SuperHouse/PWC/Hardware/PWC.brd

## EAGLE design Hardware/PWC.brd (2021-07-06)

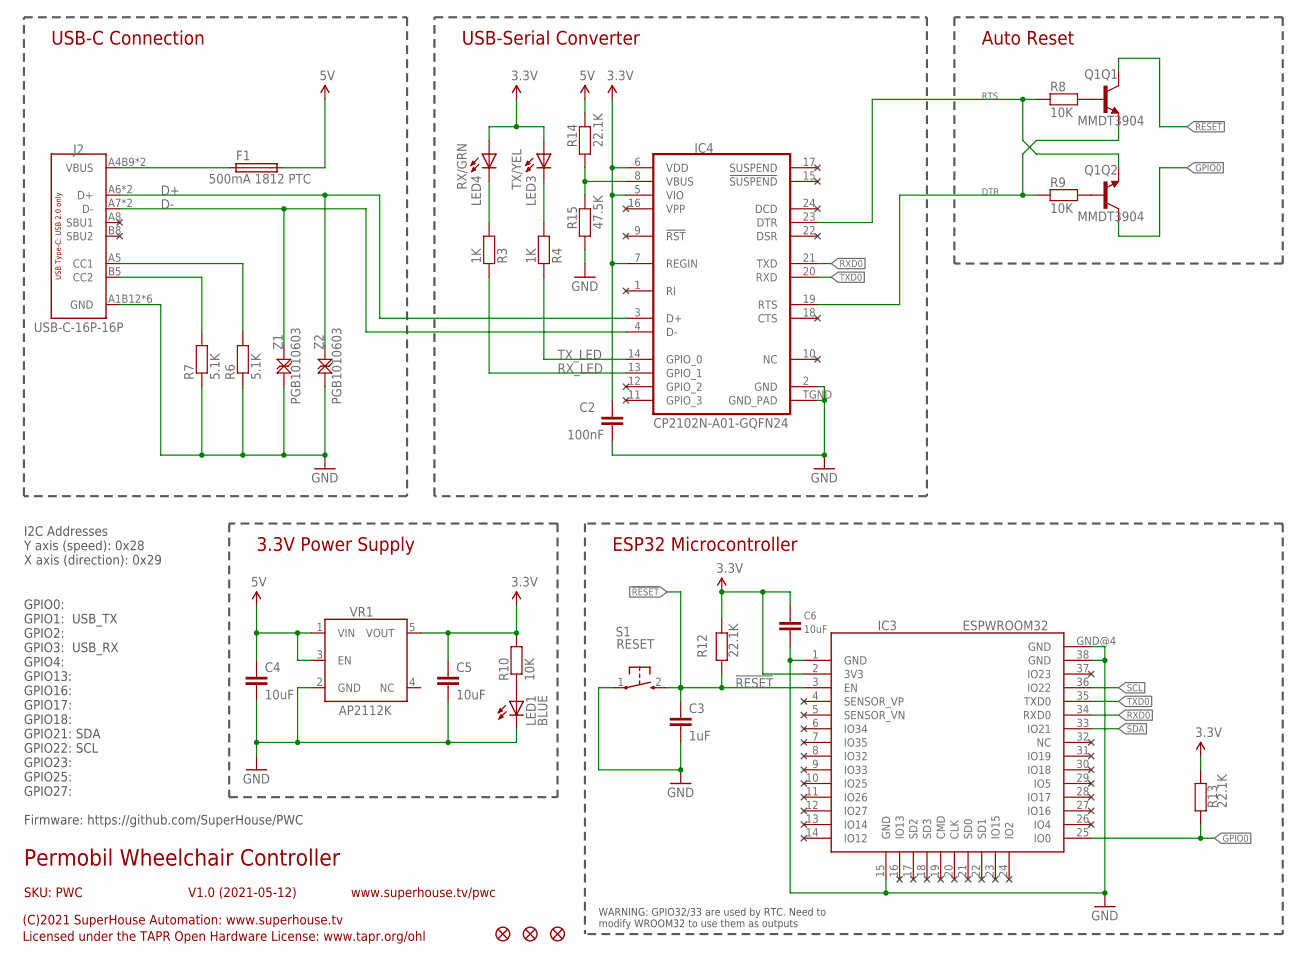
[picture p2: schematic PWC.sch, sheet 1]

Parts:
C2: 100nF; C0603
C3: 1uF; C0603
C4, C5, C6: 10uF; C0805
F1: 500mA 1812 PTC; 1812
IC3: ESPWROOM32
IC4: CP2102N-A01-GQFN24; QFN-24
J2: USB-C-16P-16P; USB-C-16P
LED1: BLUE; LED-0603
LED3: TX/YEL; LED-0603
LED4: RX/GRN; LED-0603
Q1: MMDT3904; SOT-363
R3, R4: 1K; R0603
R6, R7: 5.1K; R0603
R8, R9, R10: 10K; R0603
R12, R13, R14: 22.1K; R0603
R15: 47.5K; R0603
S1: RESET; TACTILE_SMT_3X4X2
U$35, U$36, U$37: FIDUCIAL1X2; FIDUCIAL-1X2
VR1: AP2112KSOT25; SOT23-5
Z1, Z2: PGB1010603; TVS0603

Connections:
3.3V: C2.1, C5.1, C6.1, IC3.2 (3V3), IC4.5 (VIO), IC4.6 (VDD), IC4.7 (REGIN), LED3.A, LED4.A, R10.2, R12.1, R13.1, VR1.5 (VOUT); also elsewhere on the board
5V: C4.1, F1.2, R14.2, VR1.1 (VIN), VR1.3 (EN)
!RESET: C3.1, IC3.3 (EN), Q1.3 (C), R12.2, S1.2 (S)
D+: IC4.3 (D+), J2.A6 (D+), J2.B6 (D+), Z2.2
D-: IC4.4 (D-), J2.A7 (D-), J2.B7 (D-), Z1.2
DTR: IC4.23 (DTR), Q1.1 (E), R8.1
GND: C2.2, C3.2, C4.2, C5.2, C6.2, IC3.1 (GND), IC3.15 (GND), IC3.38 (GND), IC3.GND@4 (GND), IC4.2 (GND), IC4.TGND (GND_PAD), J2.A1B12 (GND), J2.A12B1 (GND), J2.FIX1 (GND), J2.FIX2 (GND), J2.FIX3 (GND), J2.FIX4 (GND), LED1.C, R6.1, R7.1, R15.1, S1.1, VR1.2 (GND), Z1.1, Z2.1; also elsewhere on the board
GPIO0: IC3.25 (IO0), Q1.6 (C), R13.2
unnamed: LED1.A, R10.1
unnamed: Q1.5 (B), R8.2
unnamed: Q1.2 (B), R9.2
unnamed: LED4.C, R3.2
unnamed: J2.B5 (CC2), R7.2
unnamed: J2.A5 (CC1), R6.2
unnamed: LED3.C, R4.2
unnamed: IC4.8 (VBUS), R14.1, R15.2
RTS: IC4.19 (RTS), Q1.4 (E), R9.1
RXD0: IC3.34 (RXD0), IC4.21 (TXD)
RX_LED: IC4.13 (GPIO_1), R3.1
SCL: IC3.36 (IO22); also elsewhere on the board
SDA: IC3.33 (IO21); also elsewhere on the board
TXD0: IC3.35 (TXD0), IC4.20 (RXD)
TX_LED: IC4.14 (GPIO_0), R4.1
VIN: F1.1, J2.A4B9 (VBUS), J2.A9B4 (VBUS)

Notes on the sheet:
USB-C Connection
USB-Serial Converter
Auto Reset
3.3V Power Supply
ESP32 Microcontroller
WARNING: GPIO32/33 are used by RTC. Need to modify WROOM32 to use them as outputs
GPIO0: GPIO1: USB_TX GPIO2: GPIO3: USB_RX GPIO4: GPIO13: GPIO16: GPIO17: GPIO18: GPIO21: SDA GPIO22: SCL GPIO23: GPIO25: GPIO27: Firmware: https://github.com/SuperHouse/PWC
Permobil Wheelchair Controller
V1.0 (2021-05-12)
SKU: PWC
(C)2021 SuperHouse Automation: www.superhouse.tv
Licensed under the TAPR Open Hardware License: www.tapr.org/ohl
www.superhouse.tv/pwc
I2C Addresses Y axis (speed): 0x28 X axis (direction): 0x29

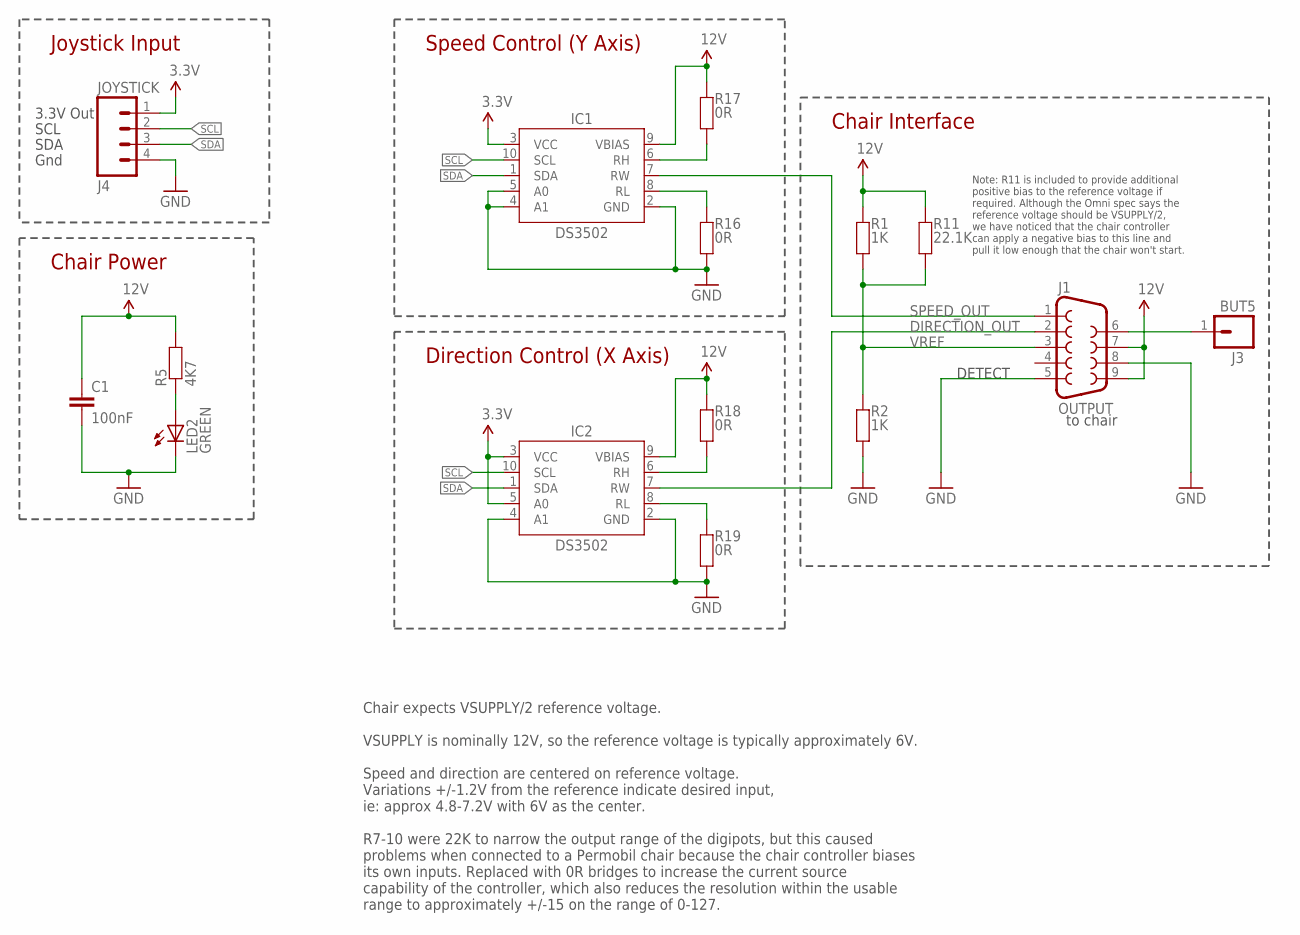
[picture p3: schematic PWC.sch, sheet 2]

Parts:
C1: 100nF; C0603
IC1, IC2: DS3502; MSOP10
J1: OUTPUT; DB9-PCB-SOCKET
J3: BUT5; 1X01
J4: JOYSTICK; 1X04
LED2: GREEN; LED-0603
R1, R2: 1K; R0603
R5: 4K7; R0603
R11: 22.1K; R0603
R16, R17, R18, R19: 0R; R0603

Connections:
3.3V: IC1.3 (VCC), IC2.3 (VCC), IC2.5 (A0), J4.1; also elsewhere on the board
12V: C1.1, IC1.9 (VBIAS), IC2.9 (VBIAS), J1.7, J1.9, R1.2, R5.2, R11.2, R17.2, R18.2
BUT5: J1.6, J3.1
DIRECTION_OUT: IC2.7 (RW), J1.2
GND: C1.2, IC1.2 (GND), IC1.4 (A1), IC1.5 (A0), IC2.2 (GND), IC2.4 (A1), J1.5, J1.8, J4.4, LED2.C, R2.1, R16.1, R19.1; also elsewhere on the board
unnamed: IC1.6 (RH), R17.1
unnamed: IC2.6 (RH), R18.1
unnamed: IC1.8 (RL), R16.2
unnamed: LED2.A, R5.1
unnamed: IC2.8 (RL), R19.2
SCL: IC1.10 (SCL), IC2.10 (SCL), J4.2; also elsewhere on the board
SDA: IC1.1 (SDA), IC2.1 (SDA), J4.3; also elsewhere on the board
SPEED_OUT: IC1.7 (RW), J1.1
VREF: J1.3, R1.1, R2.2, R11.1

Notes on the sheet:
to chair
Direction Control (X Axis)
Speed Control (Y Axis)
Chair Interface
Note: R11 is included to provide additional positive bias to the reference voltage if required. Although the Omni spec says the reference voltage should be VSUPPLY/2, we have noticed that the chair controller can apply a negative bias to this line and pull it low enough that the chair won't start.
DETECT
Chair Power
Chair expects VSUPPLY/2 reference voltage. VSUPPLY is nominally 12V, so the reference voltage is typically approximately 6V. Speed and direction are centered on reference voltage. Variations +/-1.2V from the reference indicate desired input, ie: approx 4.8-7.2V with 6V as the center. R7-10 were 22K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
Joystick Input
3.3V Out
SCL
SDA
Gnd

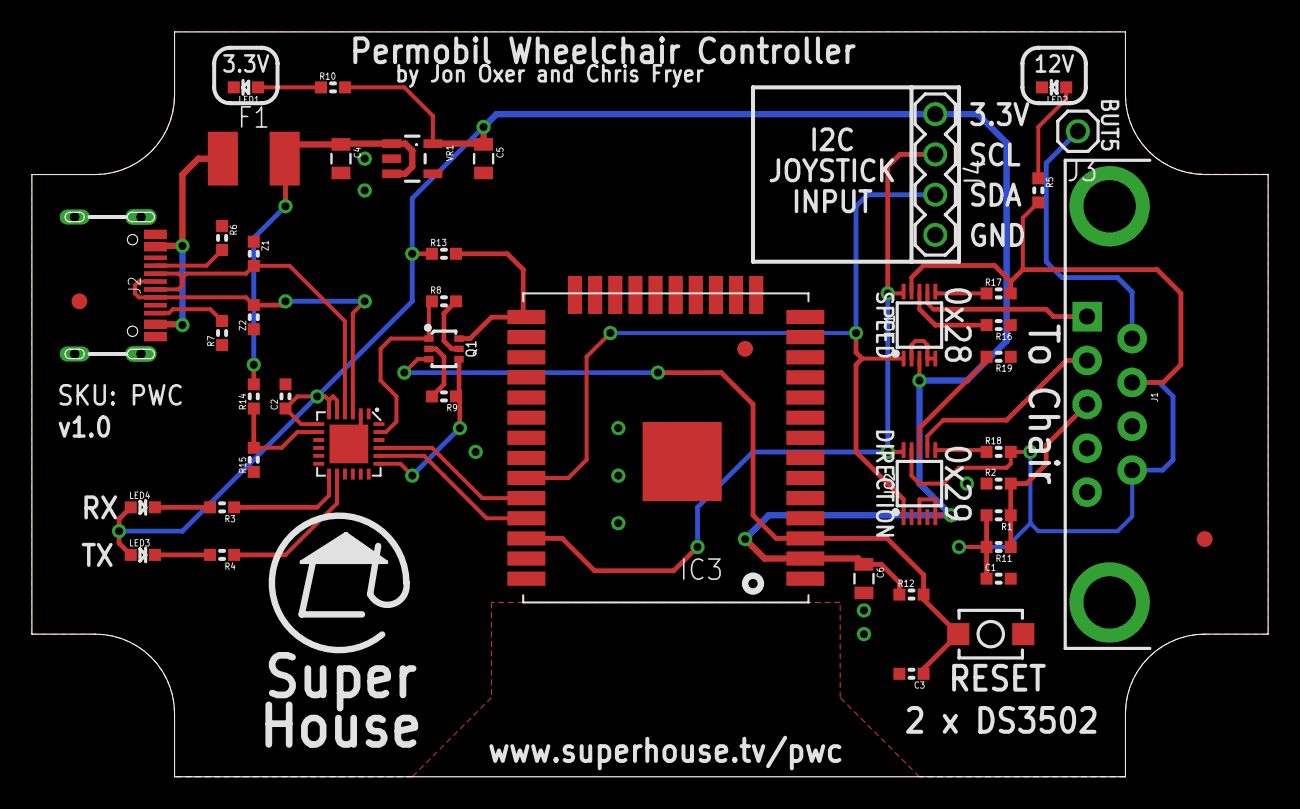
[picture p4: board PWC.brd from above]

Board: 2 copper layers, 78.0 x 47.0 mm, 46 parts (0 on the bottom side), 34 nets.
