SuperHouse/PWC/(commit log)

2021-05-25 Initial project import.
    [PWC.brd, PWC.sch]
2021-05-25 Copied the correct firmware this time!
    [PWCFirmware.ino]
2021-05-25 Removed irrelevant parts of ZeroStick firmware and changes for ESP32.
2021-05-25 Added photo of prototype.
2021-06-30 Remove startup delay to prevent Permobil controller out-of-center error.
    [PWCFirmware.ino]
2021-07-06 Fixed PS4 controller connection. Reversed Y axis on PS4 controller. Report battery level and charge state for PS4 controller.
    [PWCFirmware.ino]
2021-07-06 Updated parts to use the new SuperHouse Eagle libraries.
    [PWC.brd, PWC.sch]
